mmcmerlin/Micro-MMC/Media/3 Setup and Components.jpg

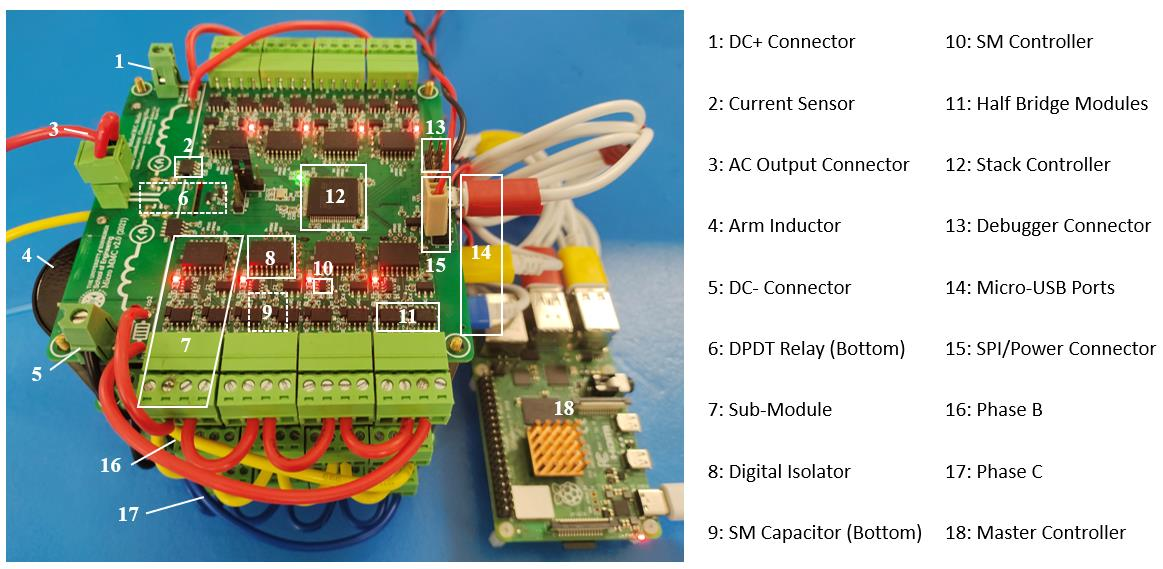
Media/3 Setup and Components.jpg
