mmcmerlin/Micro-MMC/README.md

# Micro-MMC
Schematic, PCB, and code for Micro-MMC
