mmcmerlin/Micro-MMC/Media/1 Micro-MMC Top.png

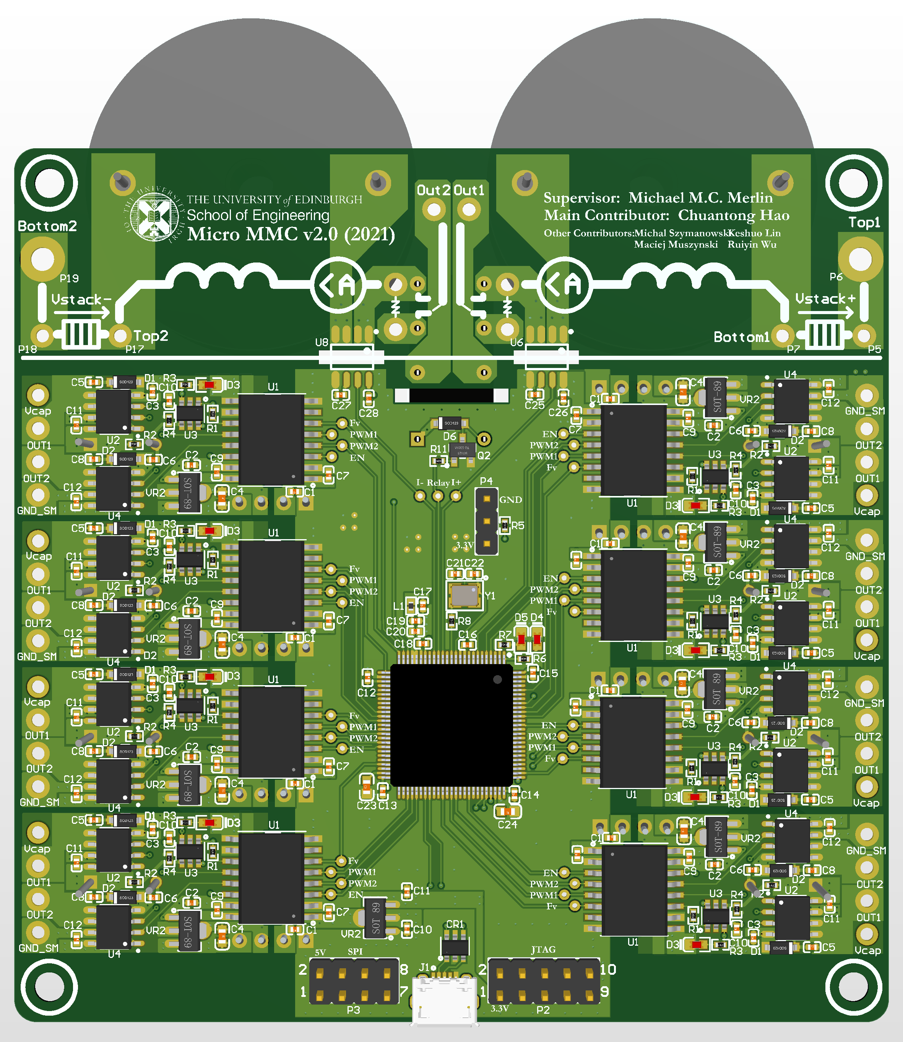
Media/1 Micro-MMC Top.png
