mmcmerlin/Micro-MMC/Media/2 Micro-MMC  Bottom.png

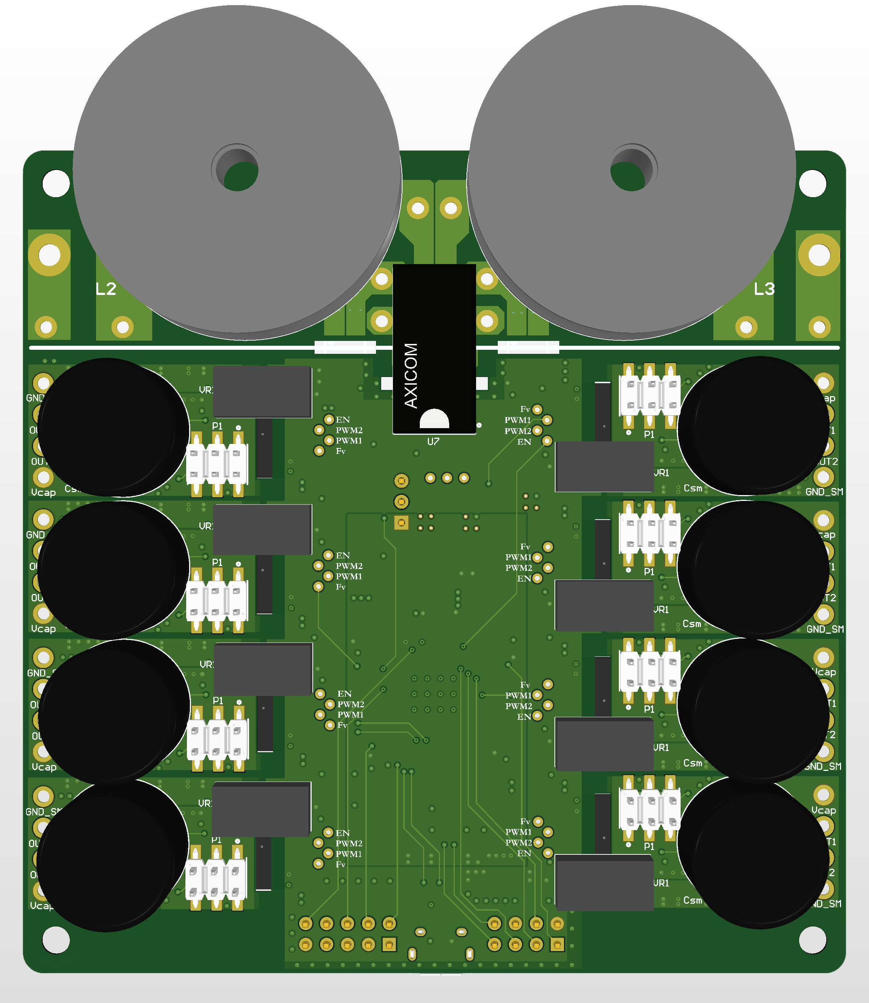
Media/2 Micro-MMC Bottom.png
