mmcmerlin/Micro-MMC/Reports/2025-05-14 Micro-MMC SM v3_4 Design 1_3.jpg

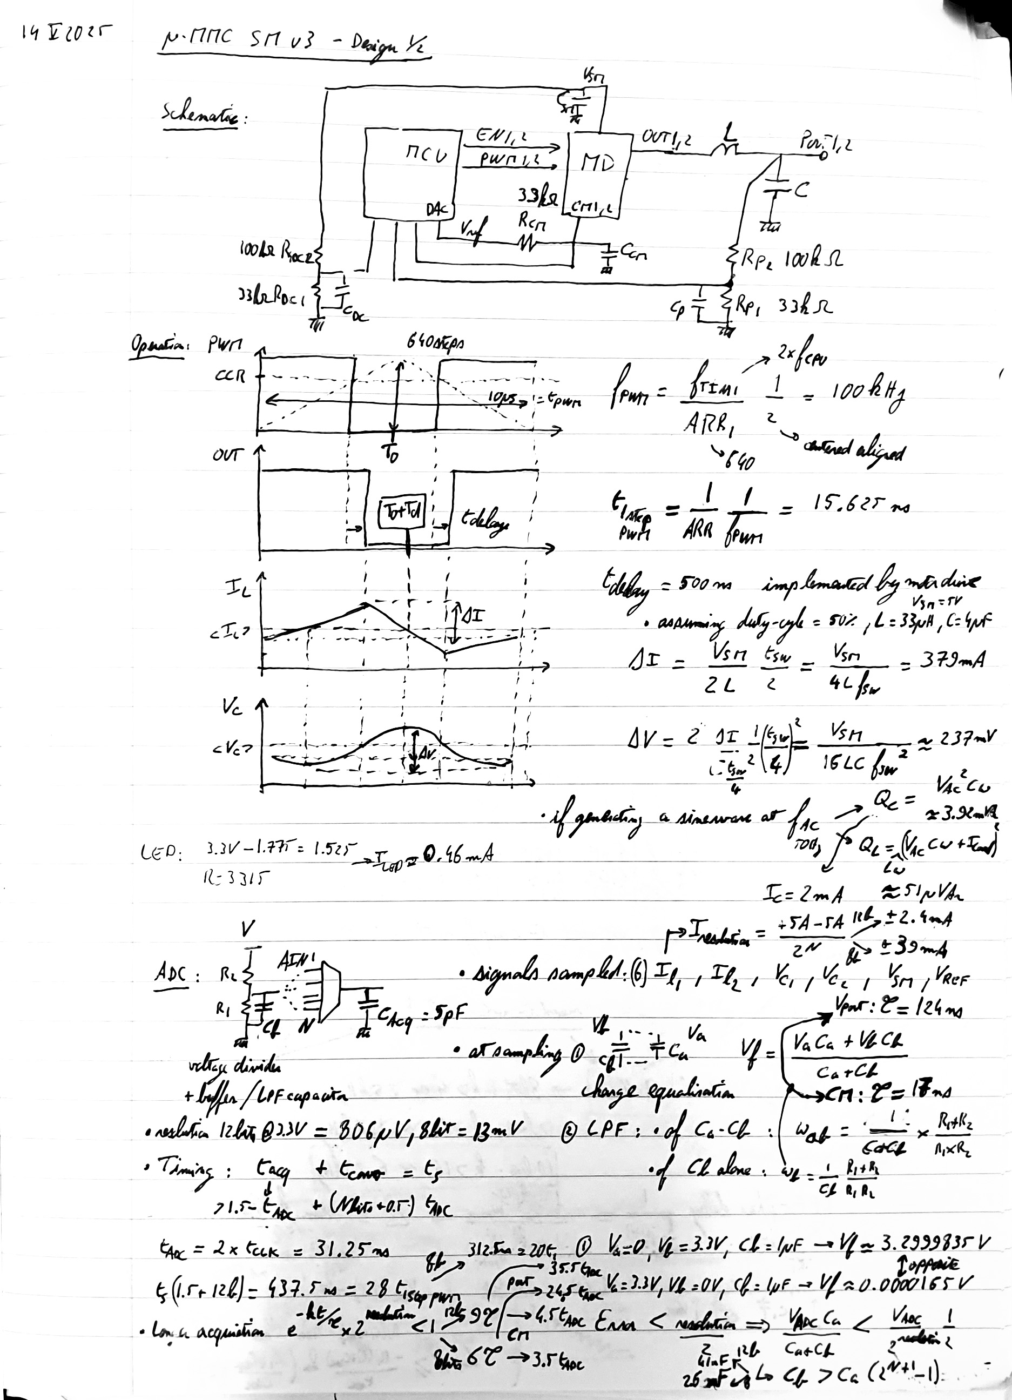
Reports/2025-05-14 Micro-MMC SM v3_4 Design 1_3.jpg
