mmcmerlin/Micro-MMC/PCB/MicroMMC_SM_v3/MicroMMC_BOMv3_4.csv

Name | Description | Designator | Quantity | JLCPCB Part # | Manufacturer 1 | Manufacturer Part Number 1 | Supplier 1 | Supplier Part Number 1 | Supplier Unit Price 1 | Supplier Order Qty 1 | Supplier Subtotal 1
860010474012 | 860010474012 WCAP-ATG8 Aluminum Electrolytic Capacitors | Csm1, Csm2 | 2 |  | Panasonic | EEU-FR1E471Y | Mouser | 667-EEU-FR1E471Y | 0.18631 | 20 | 3.72622
RC0402FR-073K3L | 3.3k | Rb1, Rb2, Rb3, Rc1, Rc2, Rd1, Rd2 | 7 | C25890 | Yageo | RC0402FR-073K3L | Mouser | 603-RC0402FR-073K3L | 0.00589 | 70 | 0.41239
STM32G071GBU6 | IC MCU 32BIT 128KB FLSH 28UFQFPN | U1 | 1 | C529347 | STMicroelectronics | STM32G071GBU6 | Mouser | 511-STM32G071GBU6 | 1.517 | 10 | 15.17
RFM-0505S | DC DC CONVERTER 5V 1W | X1 | 1 |  | Traco Power | TEA1-0505 | Mouser | 495-TEA1-0505 | 1.08252 | 10 | 10.8252
GRM155R61E105KA12D | Chip Multilayer Ceramic Capacitors for General Purpose, 0402, 1.0uF, X5R, 15%, 10%, 25V | C1, C2, C3, C4, C5, C6, C7, C8, C9, Cref | 10 | C52923 | Murata | GRM155R61E105KA12D | Mouser | 81-GRM155R61E105KA2D | 0.01178 | 100 | 1.17825
MCP1799T-3302H/TT | IC REG LINEAR 3.3V 80MA SOT23-3 | U3 | 1 | C7424770 | Microchip | MCP1799T-3302H/TT | Rs | 1981188 | 0.245 | 50 | 12.25
ISO6521REUR | Functional isolation dual-channel 1/1 digital isolator 8-VSON -40 to 125 | U4 | 1 | C22428095 | Texas Instruments | ISO6521FREUR | Mouser | 595-ISO6521FREUR | 0.59281 | 10 | 5.92808
150060RS75000 | LED Low-Power Uni-Color Red 630nm 2V 2-Pin Chip 0603(1608Metric) T/R | D1, D2 | 2 | C2286 | Wurth Electronics | 150060RS75000 | Mouser | 710-150060RS75000 | 0.11046 | 20 | 2.20922
MP6551GQB-P | Brushed DC Motor Driver Dual Half-Bridge PWM 2.5V to 14V 5A 14-Pin QFN | U2 | 1 | C3681210 | Monolithic Power Systems | MP6551GQB-P | Mouser | 946-MP6551GQB-P | 1.05306 | 10 | 10.53063
RCH1216BNP-100M | Ind Power Unshielded Wirewound 10uH 20% 1KHz Ferrite 5A Pin Box | Lf1, Lf2 | 2 |  | Sumida | RCH1216BNP-330M | Mouser | 851-RCH1216BNP-330M | 0.43964 | 20 | 8.79271
C1206C104M5RACTU | CAP CER 0.1UF 50V X7R 1206 | Cd1, Cd2, Cd3, Cd4 | 4 | C24497 | KEMET | C1206C104M5RACTU | Mouser | 80-C1206C104M5R | 0.04124 | 40 | 1.64955
GRM21BR61H475ME51L | Chip Multilayer Ceramic Capacitors for General Purpose, 0805, 4.7uF, X5R, 15%, 20%, 50V | Cout11, Cout12, Cout21, Cout22, Csm0 | 5 | C98192 | Murata | GRM21BR61H475ME51L | Mouser | 81-GRM21BR61H475M51L | 0.06922 | 50 | 3.46112
CL05B103KB5NNNC | Cap Ceramic 10nF 50V X7R ±10% SMD 0402 +125°C Paper T/R | Cf1, Cf2, Cf3 | 3 | C15195 | Samsung | CL05B103KB5NNNC | Mouser | 187-CL05B103KB5NNNC | 0.00295 | 30 | 0.08837
RC0402FR-0710KL |  | R1, R3, R4, R5, R6, R7, Rsr | 7 | C25744 | Yageo | RC0402FR-0710KL | Rs | 1987644 | 0.004 | 100 | 0.4
GJM1555C1H100JB01D | Multi-Layer Ceramic Capacitor 10pF C0G ±5% 0402 Paper T/R | Cr1, Cr2 | 2 | C32949 | Yageo | CC0402JRNPO9BN100 | Mouser | 603-CC402JRNPO9BN100 | 0.01178 | 20 | 0.23565
