mmcmerlin/Micro-MMC/PCB/MicroMMC_SM_v3/Top_Schematicv3_2.pdf

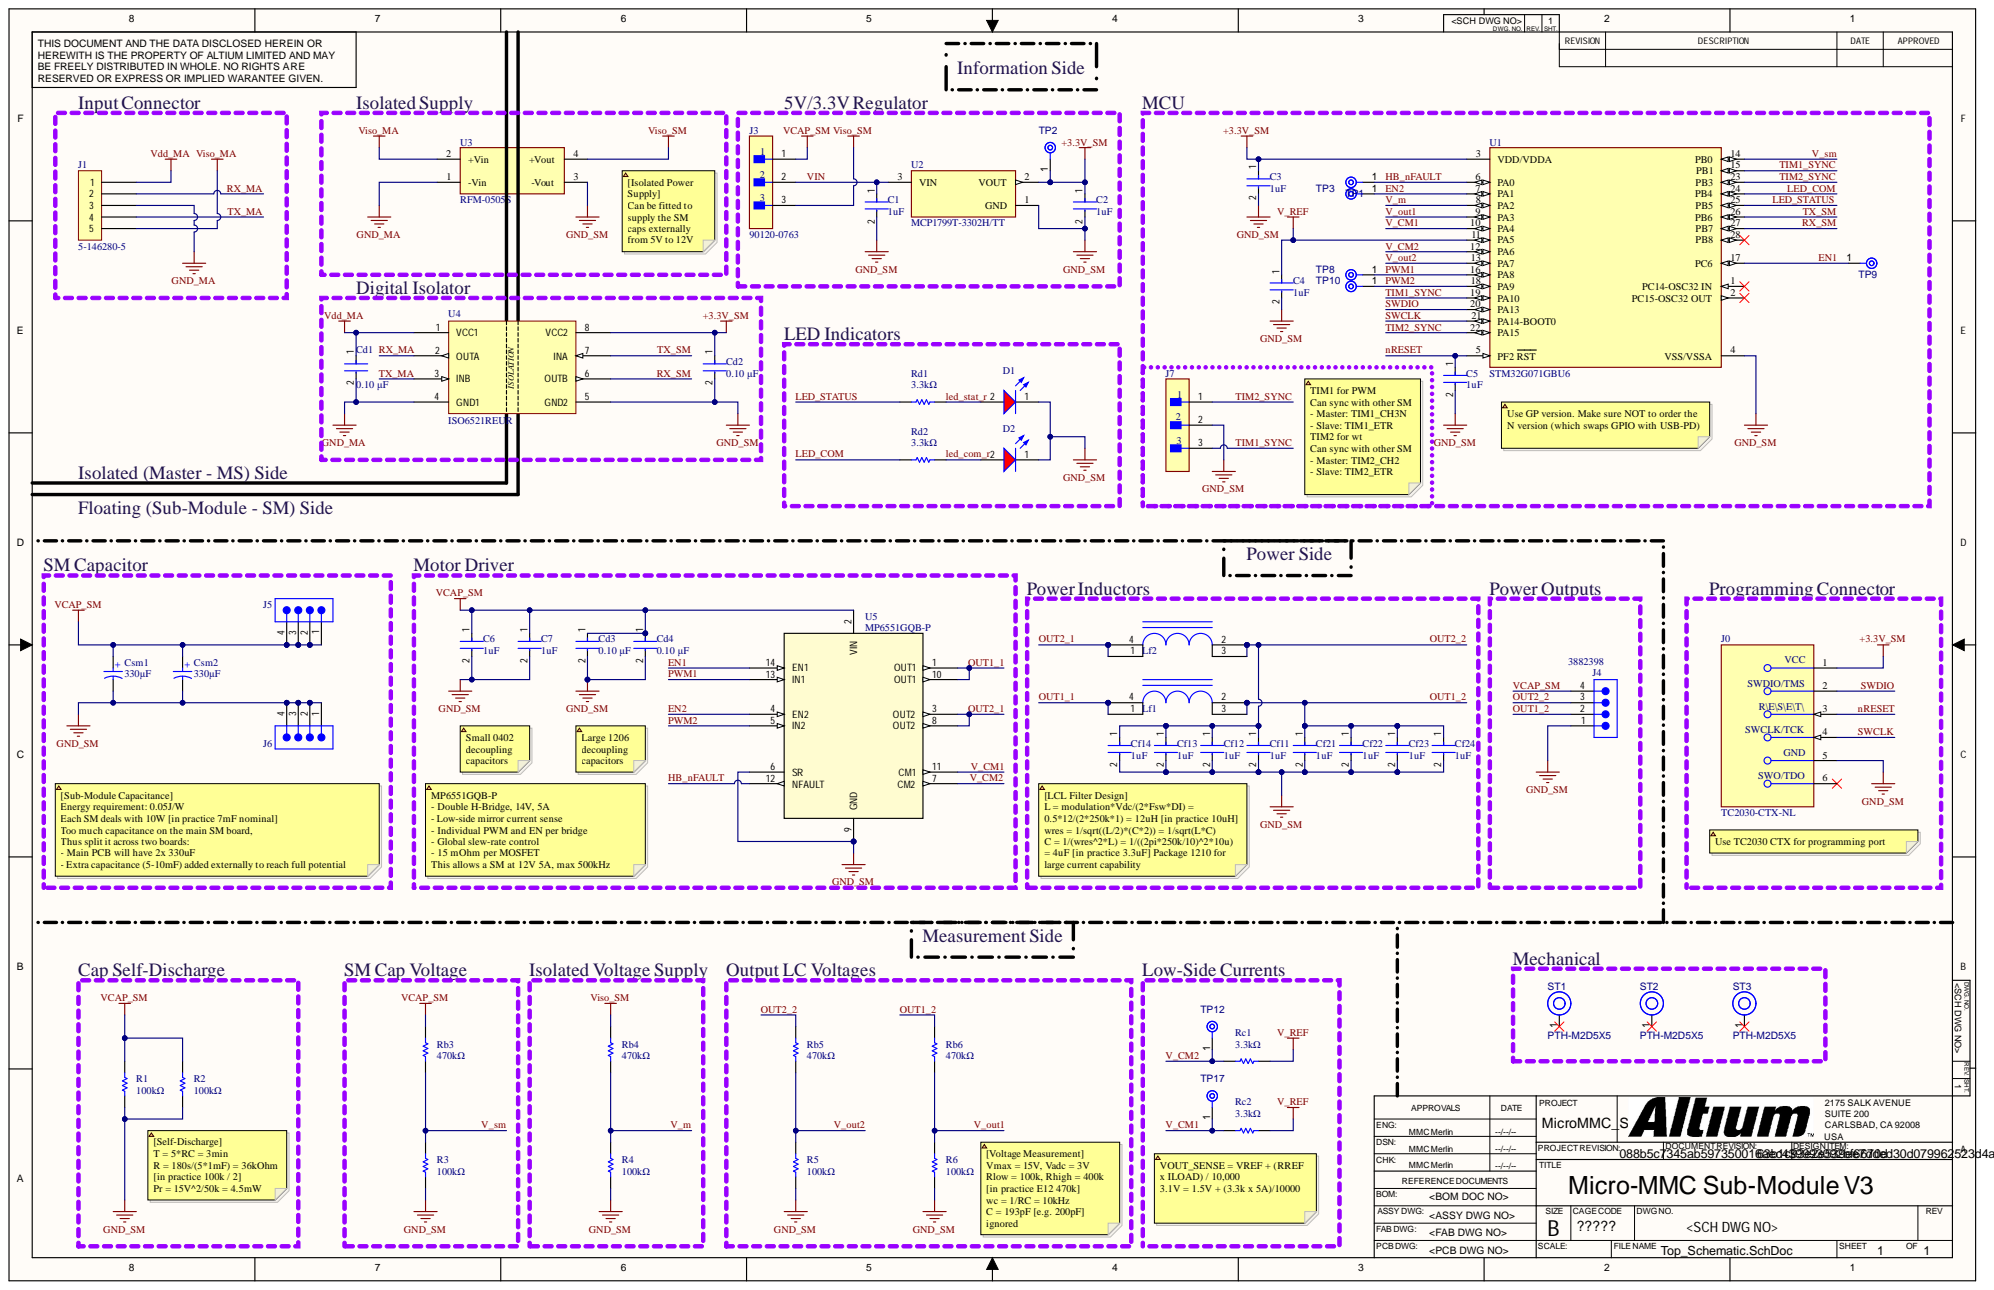
[picture p15: page 1]

<SCH DWG NO> DWG. NO. | REV. | 1 SHT.

THIS DOCUMENT AND THE DATA DISCLOSED HEREIN OR HEREWITH IS THE PROPERTY OF ALTIUM LIMITED AND MAY BE FREELY DISTRIBUTED IN WHOLE. NO RIGHTS ARE RESERVED OR EXPRESS OR IMPLIED WARANTEE GIVEN. | Isolated Supply Viso_MA | | 5V/3.3V Regulator MCU Viso_SM J3 VCAP_SM Viso_SM +3.3V_SM | REVISION | DESCRIPTION | DATE | APPROVED

[Isolated Power
Supply]
Can be fitted to
supply the SM
caps externally
from 5V to 12V

TIM1 for PWM
Can sync with other SM
- Master: TIM1_CH3N
- Slave: TIM1_ETR
TIM2 for wt
- Master: TIM2_CH2
- Slave: TIM2_ETR

Use GP version. Make sure NOT to order the
N version (which swaps GPIO with USB-PD)

Isolated (Master - MS) Side

Floating (Sub-Module - SM) Side

[Sub-Module Capacitance]
Energy requirement: 0.05J/W
Each SM deals with 10W [in practice 7mF nominal]
Too much capacitance on the main SM board,
Thus split it across two boards:
- Main PCB will have 2x 330uF
- Extra capacitance (5-10mF) added externally to reach full potential

MP6551GQB-P
- Double H-Bridge, 14V, 5A
- Low-side mirror current sense
- Individual PWM and EN per bridge
- Global slew-rate control
- 15 mOhm per MOSFET
This allows a SM at 12V 5A, max 500kHz

[LCL Filter Design]
L = modulation*Vdc/(2*Fsw*DI) =
0.5*12/(2*250k*1) = 12uH [in practice 10uH]
wres = 1/sqrt((L/2)*(C*2)) = 1/sqrt(L*C)
C = 1/(wres^2*L) = 1/((2pi*250k/10)^2*10u)
= 4uF [in practice 3.3uF] Package 1210 for
large current capability

Use TC2030 CTX for programming port

REV. SHT. DWG. NO.

DATE | PROJECT MicroMMC_SM_V3 | 2175 SALK AVENUE SUITE 200 APPROVALS CARLSBAD, CA 92008 USA

ENG: MMC Merlin | --/--/--

DSN: MMC Merlin | --/--/-- | PROJECTREVISION: | DOCUMENTREVISION: | DESIGN ITEM:

CHK: MMC Merlin | --/--/--

088b5c7345ab5973500166a3ebc41c93939e923e059329bef6e76d7d0edd30d079962523d4af94fc
Micro-MMC Sub-Module V3
