mmcmerlin/Micro-MMC/PCB/MicroMMC_SM_v3/Top_Schematicv3_5.pdf

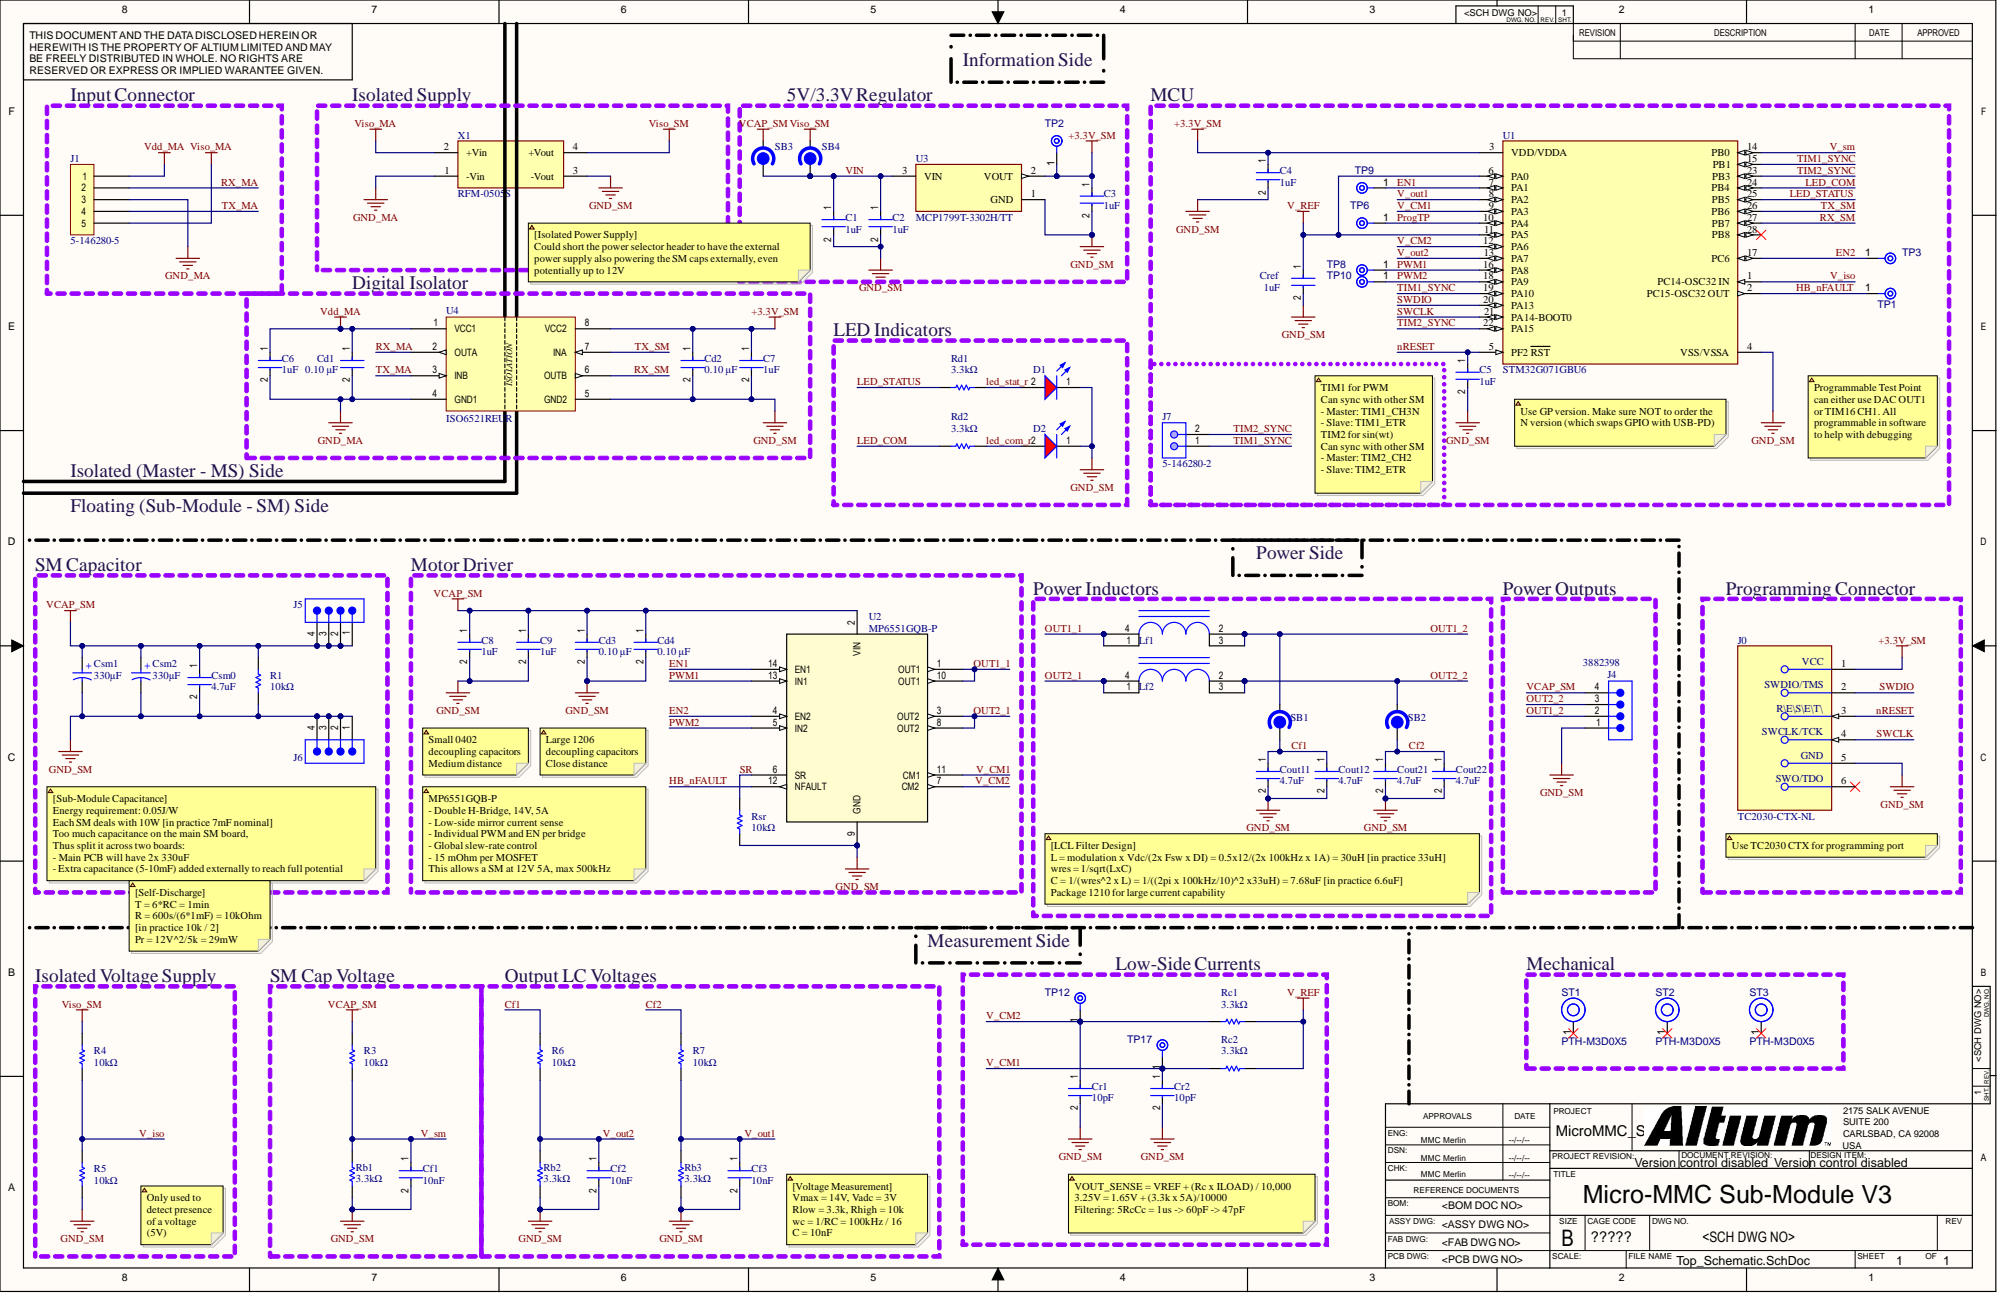
[picture p16: page 1]

<SCH DWG NO> DWG. NO. | REV. | 1 SHT.

THIS DOCUMENT AND THE DATA DISCLOSED HEREIN OR HEREWITH IS THE PROPERTY OF ALTIUM LIMITED AND MAY BE FREELY DISTRIBUTED IN WHOLE. NO RIGHTS ARE RESERVED OR EXPRESS OR IMPLIED WARANTEE GIVEN. | Viso_MA | | Viso_SM VCAP_SM Viso_SM +3.3V_SM | REVISION | DESCRIPTION | DATE | APPROVED

[Isolated Power Supply]
Could short the power selector header to have the external
power supply also powering the SM caps externally, even
potentially up to 12V

TIM1 for PWM
Can sync with other SM
- Master: TIM1_CH3N
- Slave: TIM1_ETR
TIM2 for sin(wt)
- Master: TIM2_CH2
- Slave: TIM2_ETR

Programmable Test Point
can either use DAC OUT1
or TIM16 CH1. All
programmable in software
to help with debugging

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

Isolated (Master - MS) Side

Floating (Sub-Module - SM) Side

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

[LCL Filter Design]
L = modulation x Vdc/(2x Fsw x DI) = 0.5x12/(2x 100kHz x 1A) = 30uH [in practice 33uH]
wres = 1/sqrt(LxC)
C = 1/(wres^2 x L) = 1/((2pi x 100kHz/10)^2 x33uH) = 7.68uF [in practice 6.6uF]
Package 1210 for large current capability

Use TC2030 CTX for programming port

REV. SHT. DWG. NO.

DATE | PROJECT MicroMMC_SM_V3 | 2175 SALK AVENUE SUITE 200 APPROVALS CARLSBAD, CA 92008 USA

ENG: MMC Merlin | --/--/--

DSN: MMC Merlin | --/--/--

PROJECT REVISION: Version | DOCUMENT REVISION: control disabled Version control disabled | DESIGN ITEM:

CHK: MMC Merlin | --/--/--

TITLE
Micro-MMC Sub-Module V3
