mmcmerlin/Micro-MMC/PCB/MicroMMC_SM_v3/Micro-MMCv3_4_Draftman.pdf

SB2

# TP17Rsr

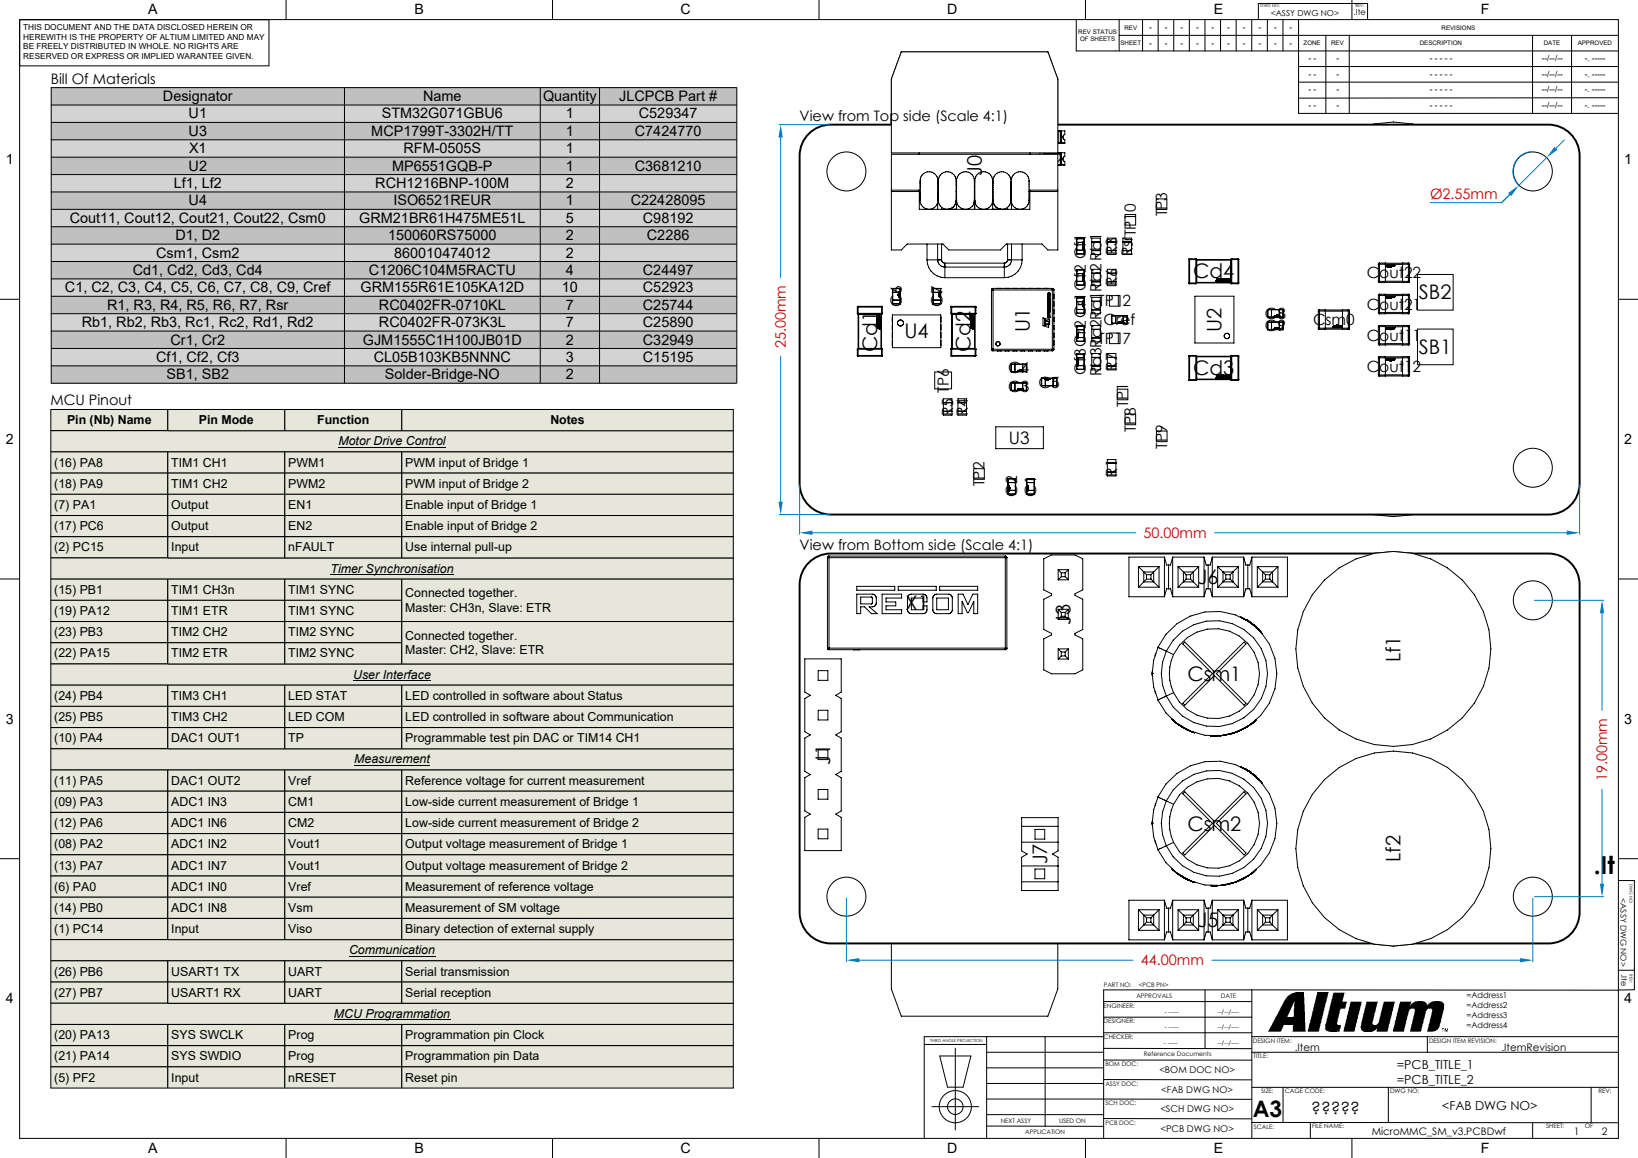
[picture p17: page 1]

THIS DOCUMENT AND THE DATA DISCLOSED HEREIN OR
HEREWITH IS THE PROPERTY OF ALTIUM LIMITED AND MAY
BE FREELY DISTRIBUTED IN WHOLE. NO RIGHTS ARE
RESERVED OR EXPRESS OR IMPLIED WARANTEE GIVEN.
Bill Of Materials

Designator | Name | Quantity | JLCPCB Part #
U1 | STM32G071GBU6 | 1 | C529347
U3 | MCP1799T-3302H/TT | 1 | C7424770
X1 | RFM-0505S | 1
U2 | MP6551GQB-P | 1 | C3681210
Lf1, Lf2 | RCH1216BNP-100M | 2
U4 | ISO6521REUR | 1 | C22428095

View from Top side (Scale 4:1)

Cout11, Cout12, Cout21, Cout22, Csm0 | GRM21BR61H475ME51L | 5 | C98192

D1, D2 | 150060RS75000 | 2 | C2286
Csm1, Csm2 | 860010474012 | 2
Cd1, Cd2, Cd3, Cd4 | C1206C104M5RACTU | 4 | C24497

C1, C2, C3, C4, C5, C6, C7, C8, C9, Cref | GRM155R61E105KA12D | 10 | C52923
R1, R3, R4, R5, R6, R7, Rsr | RC0402FR-0710KL | 7 | C25744
Rb1, Rb2, Rb3, Rc1, Rc2, Rd1, Rd2 | RC0402FR-073K3L | 7 | C25890

Cf1, Cf2, Cf3 | CL05B103KB5NNNC | 3 | C15195
SB1, SB2 | Solder-Bridge-NO | 2

PWM input of Bridge 1
PWM input of Bridge 2
Enable input of Bridge 1
Enable input of Bridge 2
Use internal pull-up

View from Bottom side (Scale 4:1)

LED controlled in software about Status
LED controlled in software about Communication
Programmable test pin DAC or TIM14 CH1

Reference voltage for current measurement
Low-side current measurement of Bridge 1
Low-side current measurement of Bridge 2
Output voltage measurement of Bridge 1
Output voltage measurement of Bridge 2
Measurement of reference voltage
Measurement of SM voltage
Binary detection of external supply

PART NO: <PCB PN>

APPROVALS | DATE

ENGINEER: - ----- | --/--/----

DESIGNER: - ----- | --/--/----

THIRD ANGLE PROJECTION

CHECKER: - ----- | --/--/----

SCH DOC: <SCH DWG NO>

NEXT ASSY | USED ON

### Top Layer (Scale 2:1) Realistic View

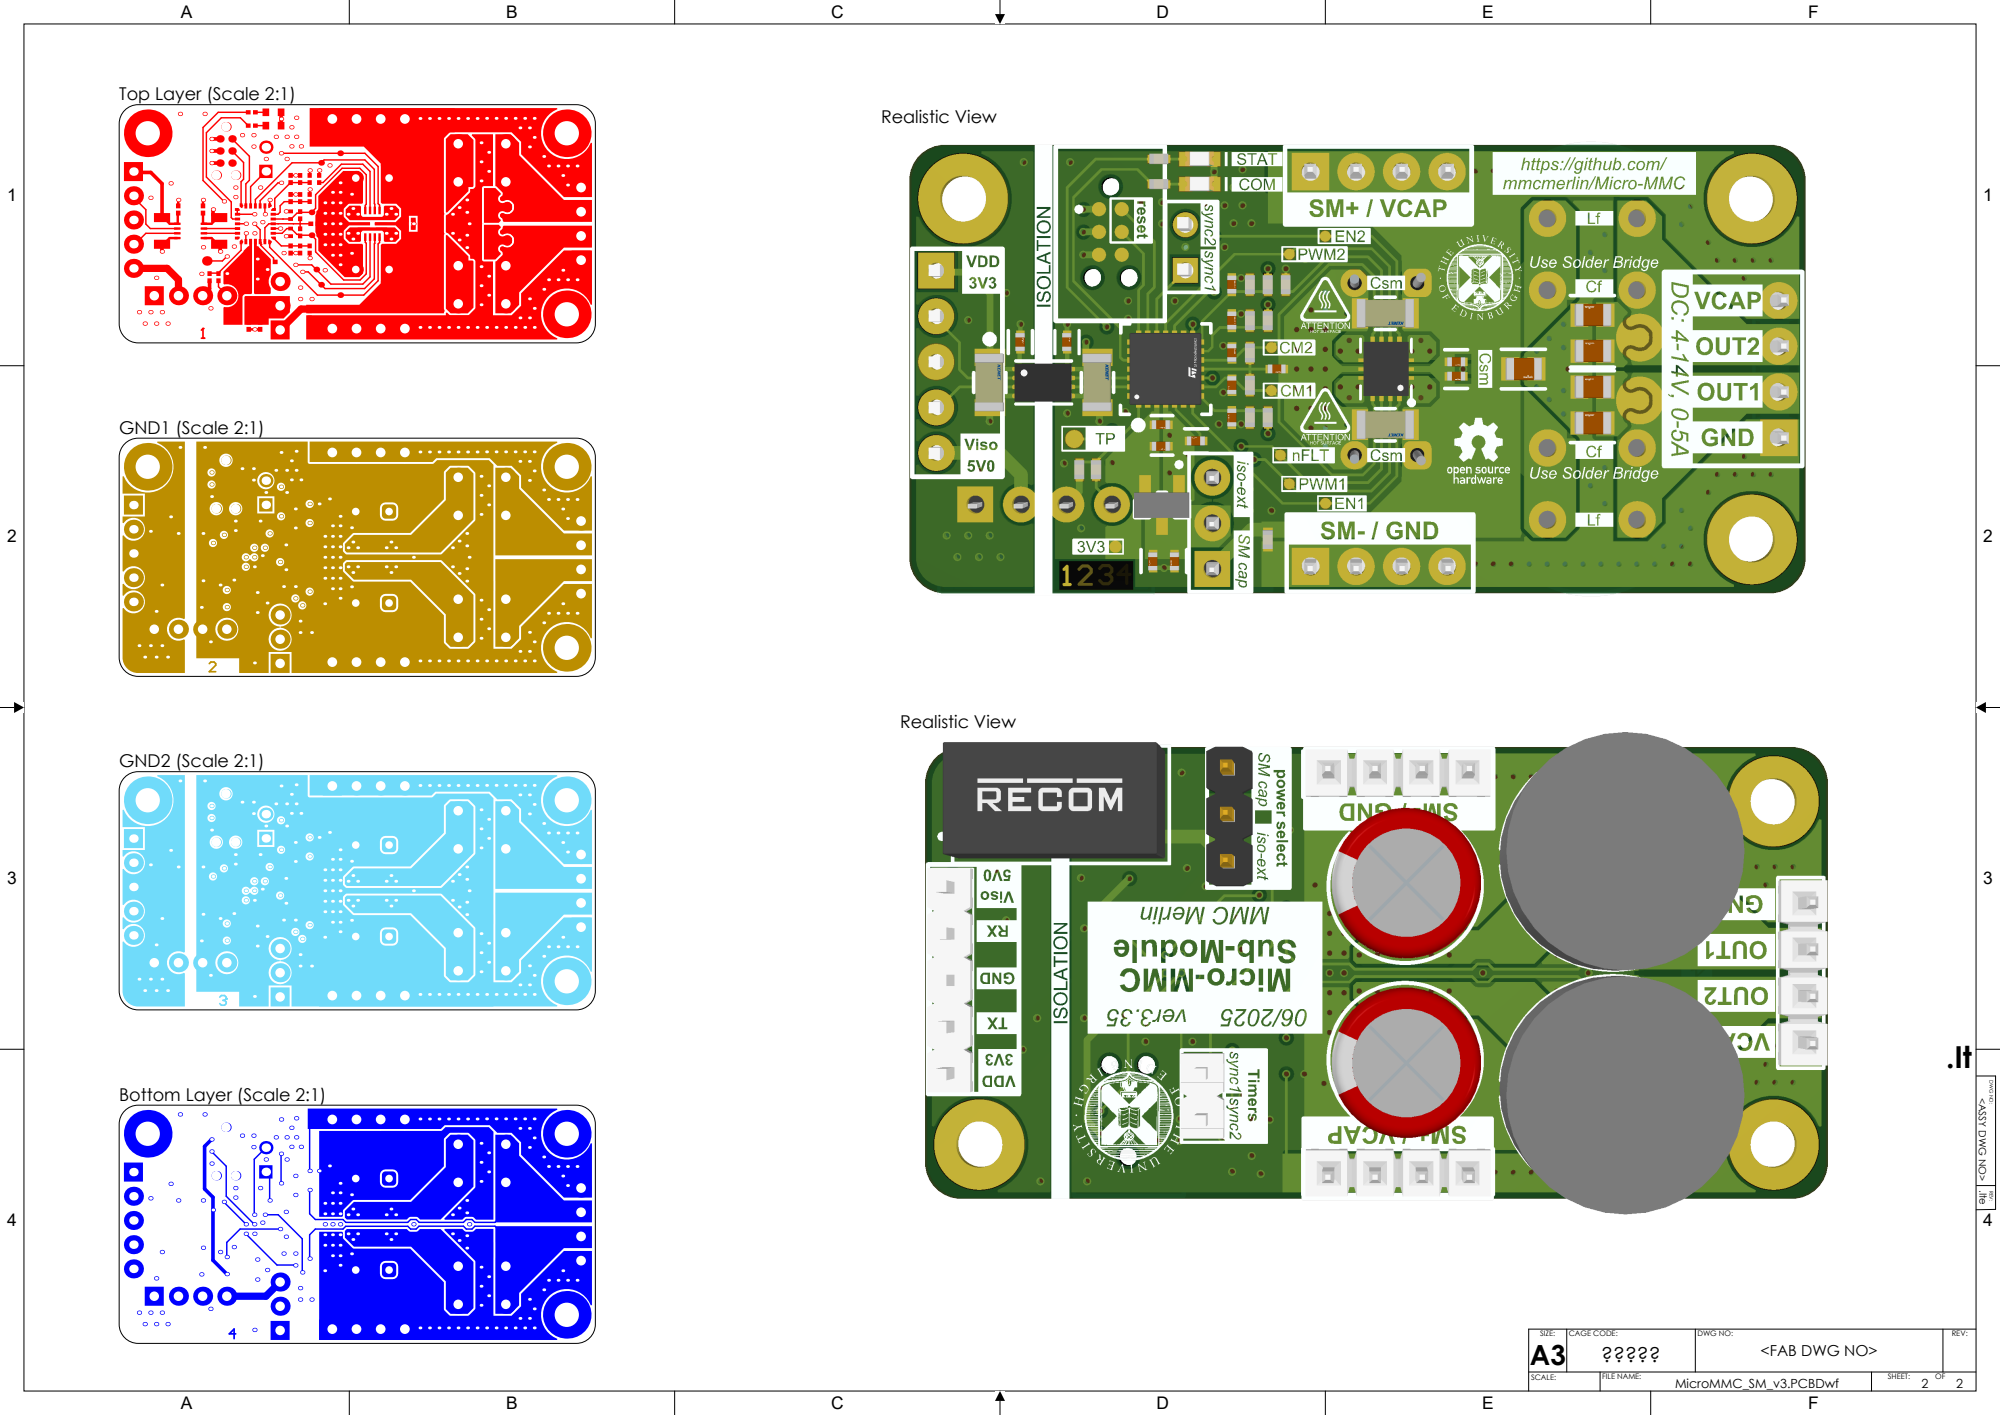
[picture p18: page 2]
GND1 (Scale 2:1); GND2 (Scale 2:1); DWG NO:; .Ite REV:; FILE NAME:; MicroMMC_SM_v3.PCBDwf; SCALE:; REV:; SIZE:; CAGE CODE:; SHEET:; Realistic View

Bottom Layer (Scale 2:1)

<ASSY DWG NO>

<FAB DWG NO>
