mmcmerlin/Micro-MMC/PCB/MicroMMC_SM_v3/Micro-MMCv3_Draftman.pdf

Cf2

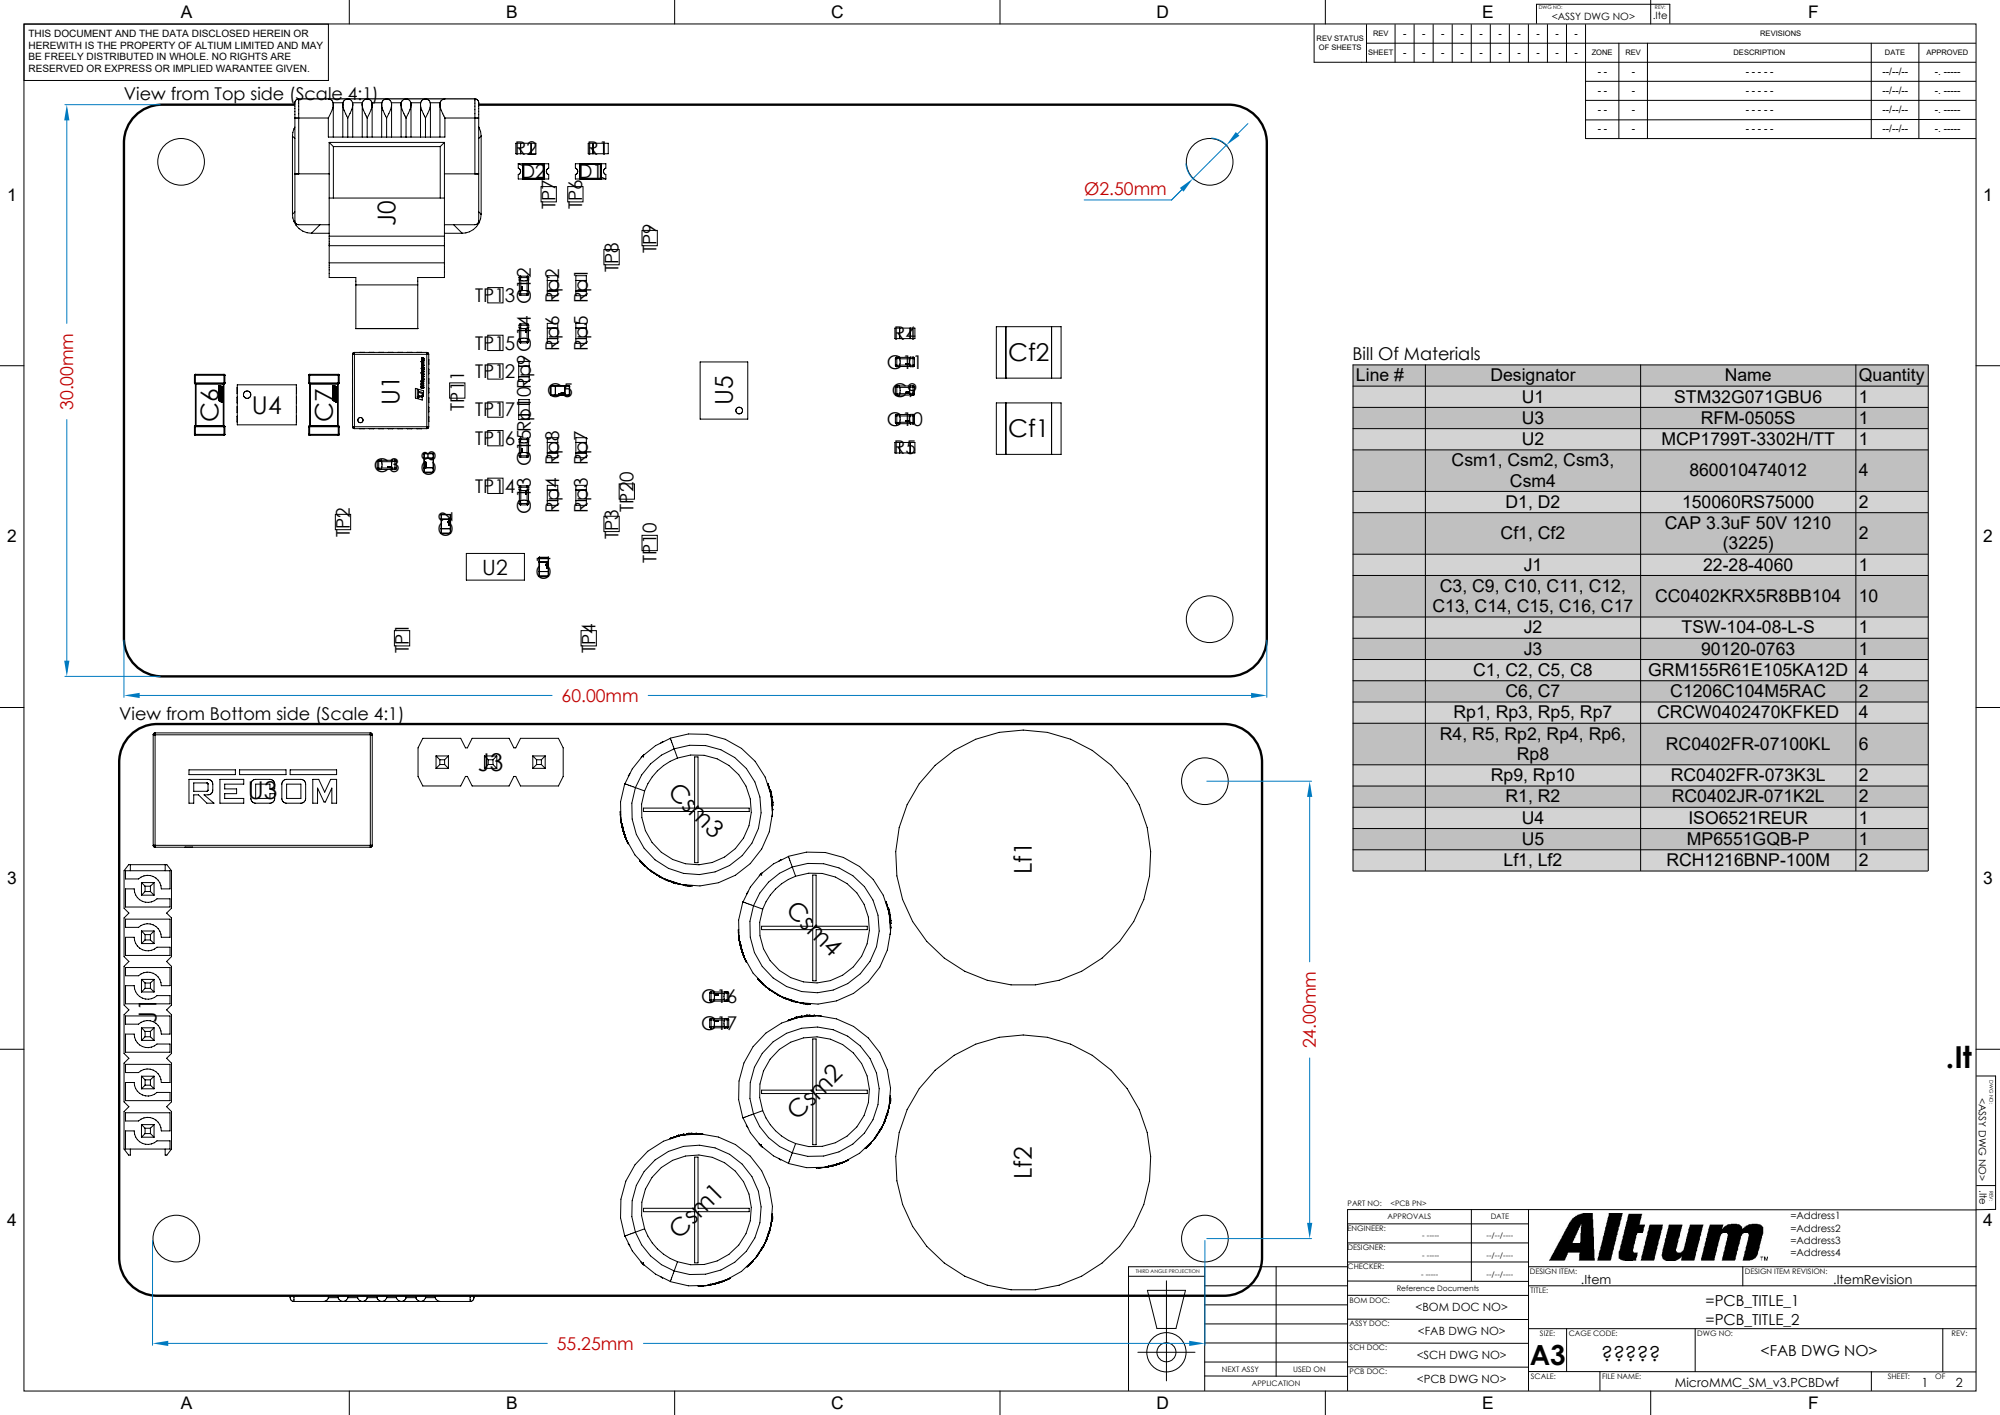
[picture p19: page 1]

THIS DOCUMENT AND THE DATA DISCLOSED HEREIN OR
HEREWITH IS THE PROPERTY OF ALTIUM LIMITED AND MAY
BE FREELY DISTRIBUTED IN WHOLE. NO RIGHTS ARE
RESERVED OR EXPRESS OR IMPLIED WARANTEE GIVEN.

View from Top side (Scale 4:1)

Line # | Designator | Name | Quantity

U1 | STM32G071GBU6 | 1

Csm1, Csm2, Csm3, Csm4 | 860010474012 | 4

D1, D2 | 150060RS75000 | 2
Cf1, Cf2 | CAP 3.3uF 50V 1210 (3225) | 2

C3, C9, C10, C11, C12, C13, C14, C15, C16, C17 | CC0402KRX5R8BB104 | 10

J2 | TSW-104-08-L-S | 1
J3 | 90120-0763 | 1
C1, C2, C5, C8 | GRM155R61E105KA12D | 4
C6, C7 | C1206C104M5RAC | 2
Rp1, Rp3, Rp5, Rp7 | CRCW0402470KFKED | 4
R4, R5, Rp2, Rp4, Rp6, Rp8 | RC0402FR-07100KL | 6

View from Bottom side (Scale 4:1)

Rp9, Rp10 | RC0402FR-073K3L | 2
R1, R2 | RC0402JR-071K2L | 2
U4 | ISO6521REUR | 1
U5 | MP6551GQB-P | 1
Lf1, Lf2 | RCH1216BNP-100M | 2

PART NO: <PCB PN>

APPROVALS | DATE

ENGINEER: - ----- | --/--/----

DESIGNER: - ----- | --/--/----

THIRD ANGLE PROJECTION

CHECKER: - ----- | --/--/----

SCH DOC: <SCH DWG NO>

NEXT ASSY | USED ON

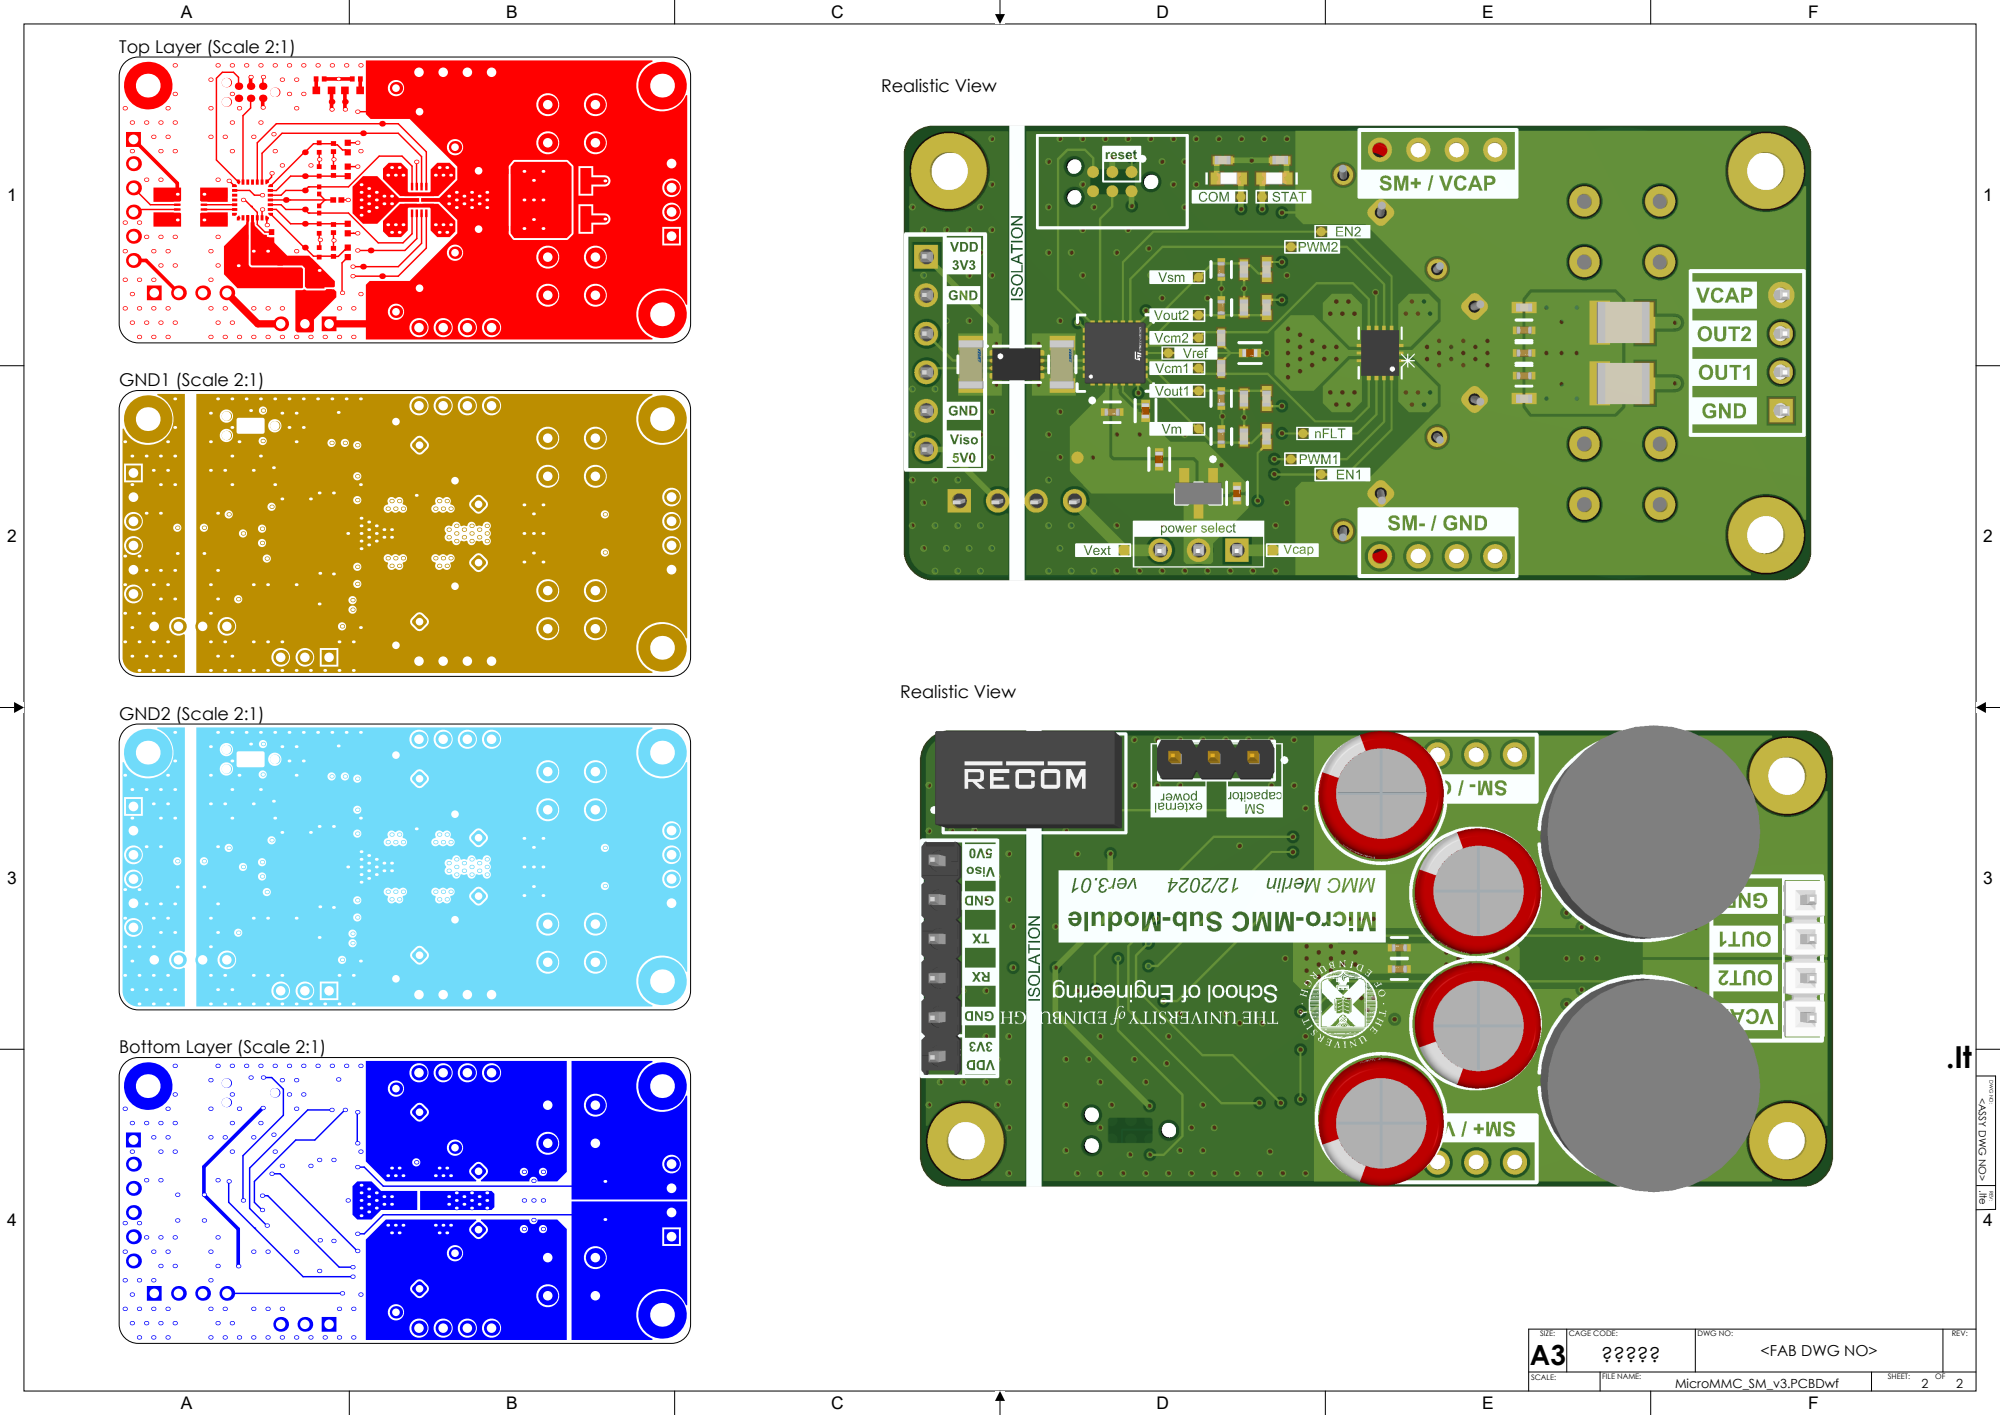
[picture p20: page 2]
GND1 (Scale 2:1); GND2 (Scale 2:1); DWG NO:; .Ite REV:; FILE NAME:; MicroMMC_SM_v3.PCBDwf; SCALE:; REV:; SIZE:; CAGE CODE:; SHEET:; Realistic View

Top Layer (Scale 2:1)

Bottom Layer (Scale 2:1)

<ASSY DWG NO>

<FAB DWG NO>
