mmcmerlin/Micro-MMC/(list of files, drawings)

Other design files:
PCB/MicroMMC_SM_Cap/MicroMMC_SM_Cap.PcbDoc
PCB/MicroMMC_SM_Cap/MicroMMC_SM_Cap.PrjPcb
PCB/MicroMMC_SM_Cap/Schematic.SchDoc
PCB/MicroMMC_SM_v3/MicroMMC_SM_v3.PcbDoc
PCB/MicroMMC_SM_v3/MicroMMC_SM_v3.PrjPcb
PCB/MicroMMC_SM_v3/Top_Schematic.SchDoc
