mmcmerlin/Micro-MMC/STM32 Code/MicroMMC_SM_V3_4/Core/Src/main.c

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
/* Includes ------------------------------------------------------------------*/
#include "main.h"

/* USER CODE BEGIN Includes */

#include <data_tables.h>

/* USER CODE END Includes */

/* USER CODE BEGIN PTD */

#define TIMER_CLK		64000000
#define TIMER1_ARR  	640
#define TIMER2_ARR  	1000
#define ADC_RESOLUTION 	1024
#define DMA_SAMPLES_BIT	3
#define DMA_SAMPLES 	8 		//2^DMA_SAMPLES_BIT or (1<<(DMA_SAMPLES_BIT-1))
#define ADC_CHANNELS 	7
#define DMA_BUFFER_SIZE	ADC_CHANNELS*DMA_SAMPLES
#define DAC_OFFSET		2048	// 1.65V/3.3*DAC_RESOLUTION
#define	PI				3.1415926535
#define MESSAGE_LENGTH	4

/* USER CODE END PTD */

ADC_HandleTypeDef hadc1;
DMA_HandleTypeDef hdma_adc1;

DAC_HandleTypeDef hdac1;

TIM_HandleTypeDef htim1;
TIM_HandleTypeDef htim2;
TIM_HandleTypeDef htim3;
DMA_HandleTypeDef hdma_tim1_ch1;
DMA_HandleTypeDef hdma_tim1_ch2;
DMA_HandleTypeDef hdma_tim3_ch1;
DMA_HandleTypeDef hdma_tim3_ch2;

UART_HandleTypeDef huart1;
DMA_HandleTypeDef hdma_usart1_rx;
DMA_HandleTypeDef hdma_usart1_tx;

/* USER CODE BEGIN PV */

uint16_t dma_buffer[2 * DMA_BUFFER_SIZE];
uint16_t bufferStart = 0;
uint8_t processData_flag = 0;
  // variables for ADC calculation
int32_t i1_sum = 0, i2_sum = 0;
uint32_t v1_sum = 0, v2_sum = 0, vsm_sum = 0, vref_sum = 0;
uint32_t cpu_temp_sum = 0;
int32_t i1_avg, i2_avg;
uint32_t v1_avg, v2_avg, vsm_avg, vref_avg;
uint32_t cpu_temp_avg;
	// variables for UART
uint8_t UART1_rxBuffer[2 * MESSAGE_LENGTH] = {0};

/* USER CODE END PV */

void SystemClock_Config(void);
static void MX_GPIO_Init(void);
static void MX_DMA_Init(void);
static void MX_DAC1_Init(void);
static void MX_TIM1_Init(void);
static void MX_TIM2_Init(void);
static void MX_TIM3_Init(void);
static void MX_ADC1_Init(void);
static void MX_USART1_UART_Init(void);
/* USER CODE BEGIN 0 */

void Process_ADC_data(void)
{
	uint16_t *buffer = &dma_buffer[bufferStart];
	i1_sum = 0, i2_sum = 0, v1_sum = 0, v2_sum = 0, vsm_sum = 0, vref_sum = 0, cpu_temp_sum = 0;
	for (int i = 0; i < DMA_SAMPLES; ++i) {
		i1_sum += buffer[0];
		i2_sum += buffer[1];
		v1_sum += buffer[2];
		v2_sum += buffer[3];
		vsm_sum += buffer[4];
		vref_sum += buffer[5];
		cpu_temp_sum += buffer[6];

		// move pointer to the next sequence
		buffer += ADC_CHANNELS;
		}

	vref_avg = (vref_sum >> DMA_SAMPLES_BIT);
	i1_avg = (int32_t)(i1_sum >> DMA_SAMPLES_BIT) - vref_avg;
	i2_avg = (int32_t)(i2_sum >> DMA_SAMPLES_BIT) - vref_avg;
	v1_avg = (v1_sum >> DMA_SAMPLES_BIT);
	v2_avg = (v1_sum >> DMA_SAMPLES_BIT);
	vsm_avg = (vsm_sum >> DMA_SAMPLES_BIT);
	cpu_temp_avg = (cpu_temp_sum >> DMA_SAMPLES_BIT);

	/*
	// VDDA can be calculated based on the measured vref and the calibration data
	vdda = (float) VREFINT_CAL_VREF * (float) *VREFINT_CAL_ADDR / vref_avg / 1000;

	// Knowing vdda and the resolution of adc - the actual voltage can be calculated
	vref = (float) vdda / ADC_RESOLUTION * vref_avg;

	// Temperature can be calculated based on the
	temp = (float) ((float) ((float) (TEMPSENSOR_CAL2_TEMP - TEMPSENSOR_CAL1_TEMP) / (float) (*TEMPSENSOR_CAL2_ADDR - *TEMPSENSOR_CAL1_ADDR)) * (temp_avg *TEMPSENSOR_CAL1_ADDR) + TEMPSENSOR_CAL1_TEMP);
	*/

	processData_flag = 0;

	return;
}

/* USER CODE END 0 */

/**
  * @brief  The application entry point.
  * @retval int
  */
int main(void)
{

  /* MCU Configuration--------------------------------------------------------*/

  /* Reset of all peripherals, Initializes the Flash interface and the Systick. */
  HAL_Init();

  /* Configure the system clock */
  SystemClock_Config();

  /* Initialize all configured peripherals */
  MX_GPIO_Init();
  MX_DMA_Init();
  MX_DAC1_Init();
  MX_TIM1_Init();
  MX_TIM2_Init();
  MX_TIM3_Init();
  MX_ADC1_Init();
  MX_USART1_UART_Init();
  /* USER CODE BEGIN 2 */

	  // calibrate ADC for better accuracy
	if(HAL_ADCEx_Calibration_Start(&hadc1) != HAL_OK)
	  Error_Handler();

		  // Set the DC value for the DAC
	DAC1->DHR12R2 = DAC_OFFSET;
	HAL_DAC_Start(&hdac1, DAC_CHANNEL_2);

		  // Start the DMA triggered ADC
	if(HAL_ADC_Start_DMA(&hadc1, (uint32_t*) &dma_buffer, 2 * DMA_BUFFER_SIZE) != HAL_OK)
	  Error_Handler();

		  // Set up the receiving link
	HAL_UART_Receive_DMA(&huart1, UART1_rxBuffer, MESSAGE_LENGTH);

		  // Enable Pins for H-Bridges & Activate Timer 1 for PWM
	HAL_TIM_PWM_Start_DMA(&htim1, TIM_CHANNEL_1, (uint32_t *) cos_A640_M110_PH000_THI_table, COS_TABLE_LENGTH);
	HAL_TIM_PWM_Start_DMA(&htim1, TIM_CHANNEL_2, (uint32_t *) cos_A640_M110_PH090_THI_table, COS_TABLE_LENGTH);
	TIM1->CCR3 = 64; // To account for the 500ns delay in bridge switching - to be moved to CCR4

		  // Enable the Motor Drive outputs
	HAL_GPIO_WritePin(EN1_GPIO_Port, EN1_Pin, GPIO_PIN_SET);
	HAL_GPIO_WritePin(EN2_GPIO_Port, EN2_Pin, GPIO_PIN_SET);


  // Activate heartbeat patterns for LEDs
    // STAT LED
  HAL_TIM_PWM_Start_DMA(&htim3, TIM_CHANNEL_1, (uint32_t *) heartbeat_1Hz_A10000_table, HEARTBEAT_LENGTH);
    // COM LED
  HAL_TIM_PWM_Start_DMA(&htim3, TIM_CHANNEL_2, (uint32_t *) heartbeat_2Hz_A10000_table, HEARTBEAT_LENGTH);

  /* USER CODE END 2 */

  /* Infinite loop */
  /* USER CODE BEGIN WHILE */
  while (1)
  {
    /* USER CODE END WHILE */

    /* USER CODE BEGIN 3 */

	  if(processData_flag)
	  {
		  Process_ADC_data();
	  }

	  // Sleep this next interruption
	  HAL_SuspendTick();
	  HAL_PWR_EnterSLEEPMode(PWR_MAINREGULATOR_ON, PWR_SLEEPENTRY_WFI);
  }
  /* USER CODE END 3 */
}

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
/* USER CODE BEGIN 4 */

void HAL_UART_RxCpltCallback(UART_HandleTypeDef *huart)
{
    HAL_UART_Receive_DMA(&huart1, UART1_rxBuffer, MESSAGE_LENGTH);
}

void HAL_ADC_ConvHalfCpltCallback(ADC_HandleTypeDef *hadc) {
    bufferStart = 0;
    processData_flag = 1;
    //HAL_GPIO_WritePin(TP_GPIO_Port, TP_Pin, GPIO_PIN_SET);
}

void HAL_ADC_ConvCpltCallback(ADC_HandleTypeDef *hadc) {
    bufferStart = DMA_BUFFER_SIZE;
    processData_flag = 1;
    //HAL_GPIO_WritePin(TP_GPIO_Port, TP_Pin, GPIO_PIN_RESET);
}


/* USER CODE END 4 */
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
