mmcmerlin/Micro-MMC/STM32 Code/MicroMMC_SM_V3_4/MicroMMC_SM_V3_4.ioc

Mcu.UserName=STM32G071GBUx
PA0.GPIO_Label=VREF_ADC
PA0.Signal=ADC1_IN0
PA1.GPIO_Label=EN1
PA1.Signal=GPIO_Output
PA13.Signal=SYS_SWDIO
PA14-BOOT0.Signal=SYS_SWCLK
PA15.Signal=S_TIM2_CH1_ETR
PA2.GPIO_Label=Vout1
PA2.Signal=ADC1_IN2
PA3.GPIO_Label=CM1
PA3.Signal=ADC1_IN3
PA4.GPIO_Label=PTP
PA4.Signal=COMP_DAC11_group
PA5.GPIO_Label=VREF_DAC
PA5.Signal=COMP_DAC12_group
PA6.GPIO_Label=CM2
PA6.Signal=ADC1_IN6
PA7.GPIO_Label=Vout2
PA7.Signal=ADC1_IN7
PA8.GPIO_Label=PWM1
PA8.Signal=S_TIM1_CH1
PB0.GPIO_Label=Vsm
PB0.Signal=ADC1_IN8
PB1.GPIO_Label=TIM1_TRIG
PB1.Signal=TIM1_CH3N
PB3.GPIO_Label=TIM2_TRIG
PB3.Signal=S_TIM2_CH2
PB4.GPIO_Label=LED_COM
PB4.Signal=S_TIM3_CH1
PB5.GPIO_Label=LED_STAT
PB5.Signal=S_TIM3_CH2
PB6.Signal=USART1_TX
PB7.Signal=USART1_RX
PC6.GPIO_Label=EN2
PC6.Signal=GPIO_Output
