mmcmerlin/Micro-MMC/STM32 Code/MicroMMC_SM_V3_4/Core/Inc/main.h

#define Viso_Pin GPIO_PIN_14
#define Viso_GPIO_Port GPIOC
#define nFAULT_Pin GPIO_PIN_15
#define nFAULT_GPIO_Port GPIOC
#define VREF_ADC_Pin GPIO_PIN_0
#define VREF_ADC_GPIO_Port GPIOA
#define EN1_Pin GPIO_PIN_1
#define EN1_GPIO_Port GPIOA
#define Vout1_Pin GPIO_PIN_2
#define Vout1_GPIO_Port GPIOA
#define CM1_Pin GPIO_PIN_3
#define CM1_GPIO_Port GPIOA
#define PTP_Pin GPIO_PIN_4
#define PTP_GPIO_Port GPIOA
#define VREF_DAC_Pin GPIO_PIN_5
#define VREF_DAC_GPIO_Port GPIOA
#define CM2_Pin GPIO_PIN_6
#define CM2_GPIO_Port GPIOA
#define Vout2_Pin GPIO_PIN_7
#define Vout2_GPIO_Port GPIOA
#define Vsm_Pin GPIO_PIN_0
#define Vsm_GPIO_Port GPIOB
#define TIM1_TRIG_Pin GPIO_PIN_1
#define TIM1_TRIG_GPIO_Port GPIOB
#define PWM1_Pin GPIO_PIN_8
#define PWM1_GPIO_Port GPIOA
#define EN2_Pin GPIO_PIN_6
#define EN2_GPIO_Port GPIOC
#define PWM2_Pin GPIO_PIN_9
#define PWM2_GPIO_Port GPIOA
#define TIM2_TRIG_Pin GPIO_PIN_3
#define TIM2_TRIG_GPIO_Port GPIOB
#define LED_COM_Pin GPIO_PIN_4
#define LED_COM_GPIO_Port GPIOB
#define LED_STAT_Pin GPIO_PIN_5
#define LED_STAT_GPIO_Port GPIOB
