mmcmerlin/Micro-MMC/(commit log)

2019-10-14 Add files via upload
    mini MMC Altium files
    [1546215-4 v1.step, ACS70331EESATR-005B3--3DModel-STEP-56544.STEP, EGPD250ELL682MU40H-ND v1.step, ELBK350ELL842AM40S v1.step, IRLB8748PBF v1.step, RN122 v4.step, Resitor_SMD_ULR15S_R002FT2 v1.step, SM.SchDoc]
2026-05-14 Update to V3
    Moved V2 to the Archive folder.
    Uploaded all new files for V3.
    [1546215-4 v1.step, ACS70331EESATR-005B3--3DModel-STEP-56544.STEP, EGPD250ELL682MU40H-ND v1.step, ELBK350ELL842AM40S v1.step, IRLB8748PBF v1.step, RN122 v4.step, Resitor_SMD_ULR15S_R002FT2 v1.step, SM.SchDoc]
