mmcmerlin/Micro-MMC/(notices)

Notices in the files:
STM32 Code/MicroMMC_SM_V3_4/Core/Src/main.c:
Copyright (c) 2026 Michael Merlin, University of Edinburgh.
Copyright (c) 2026 STMicroelectronics.
All rights reserved.
This software is licensed under terms that can be found in the LICENSE file
